Tsjakka/PowerMeter/Hardware/PowerMeter_v2_PCB_koper.png

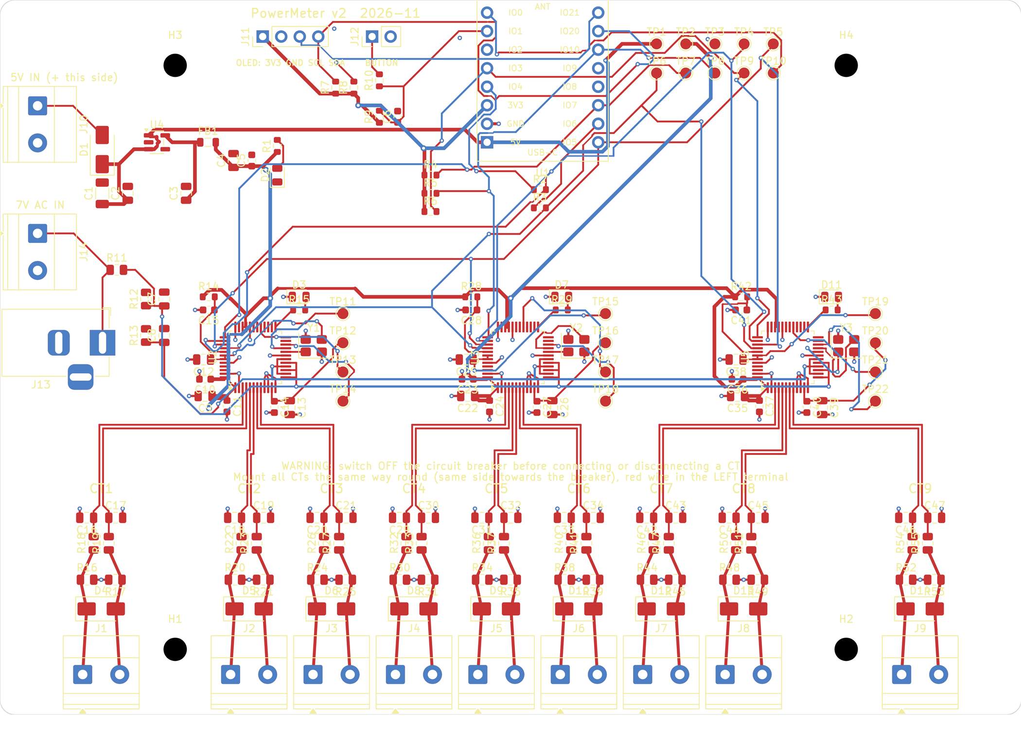
Hardware/PowerMeter_v2_PCB_koper.png
