Tsjakka/PowerMeter/Hardware/PowerMeter_v2_BOM.csv

Designator | Value | Footprint | LCSC | Qty | DNP
C1 | 22u 10V | Capacitor_SMD:C_1206_3216Metric | C12891 | 1
C2-C4,C9,C12,C22,C25,C35,C38 | 10u | Capacitor_SMD:C_0805_2012Metric | C15850 | 9
C5,C6,C10,C11,C14,C15,C23,C24,C27,C28,C36,C37,C40,C41 | 100n | Capacitor_SMD:C_0603_1608Metric | C14663 | 14
C7,C8,C16-C21,C29-C34,C42-C51 | 33n C0G | Capacitor_SMD:C_0805_2012Metric | C1518212 | 24
C13,C26,C39 | 4.7u | Capacitor_SMD:C_0805_2012Metric | C1779 | 3
D1 | SS14 | Diode_SMD:D_SMA | C2480 | 1
D2,D3,D7,D11 | groen | LED_SMD:LED_0805_2012Metric | C2297 | 4
D4-D6,D8-D10,D12-D14 | SMAJ5.0CA | Diode_SMD:D_SMA | C140894 | 9
FB1 | 600R@100MHz | Inductor_SMD:L_0805_2012Metric | C1017 | 1
J1 | CT1 | TerminalBlock_Phoenix:TerminalBlock_Phoenix_MKDS-1,5-2-5.08_1x02_P5.08mm_Horizontal |  | 1
J2 | CT2 | TerminalBlock_Phoenix:TerminalBlock_Phoenix_MKDS-1,5-2-5.08_1x02_P5.08mm_Horizontal |  | 1
J3 | CT3 | TerminalBlock_Phoenix:TerminalBlock_Phoenix_MKDS-1,5-2-5.08_1x02_P5.08mm_Horizontal |  | 1
J4 | CT4 | TerminalBlock_Phoenix:TerminalBlock_Phoenix_MKDS-1,5-2-5.08_1x02_P5.08mm_Horizontal |  | 1
J5 | CT5 | TerminalBlock_Phoenix:TerminalBlock_Phoenix_MKDS-1,5-2-5.08_1x02_P5.08mm_Horizontal |  | 1
J6 | CT6 | TerminalBlock_Phoenix:TerminalBlock_Phoenix_MKDS-1,5-2-5.08_1x02_P5.08mm_Horizontal |  | 1
J7 | CT7 | TerminalBlock_Phoenix:TerminalBlock_Phoenix_MKDS-1,5-2-5.08_1x02_P5.08mm_Horizontal |  | 1
J8 | CT8 | TerminalBlock_Phoenix:TerminalBlock_Phoenix_MKDS-1,5-2-5.08_1x02_P5.08mm_Horizontal |  | 1
J9 | CT9 | TerminalBlock_Phoenix:TerminalBlock_Phoenix_MKDS-1,5-2-5.08_1x02_P5.08mm_Horizontal |  | 1
J10 | 5V in | TerminalBlock_Phoenix:TerminalBlock_Phoenix_MKDS-1,5-2-5.08_1x02_P5.08mm_Horizontal |  | 1
J11 | OLED SSD1306 I2C | Connector_PinHeader_2.54mm:PinHeader_1x04_P2.54mm_Vertical |  | 1
J12 | Knop | Connector_PinHeader_2.54mm:PinHeader_1x02_P2.54mm_Vertical |  | 1
J13 | 7V AC L1 (jack) | Connector_BarrelJack:BarrelJack_Horizontal |  | 1
J14 | 7V AC L1 | TerminalBlock_Phoenix:TerminalBlock_Phoenix_MKDS-1,5-2-5.08_1x02_P5.08mm_Horizontal |  | 1
J15 | 7V AC L2 | TerminalBlock_Phoenix:TerminalBlock_Phoenix_MKDS-1,5-2-5.08_1x02_P5.08mm_Horizontal |  | 1
J16 | 7V AC L3 | TerminalBlock_Phoenix:TerminalBlock_Phoenix_MKDS-1,5-2-5.08_1x02_P5.08mm_Horizontal |  | 1
R1,R10,R15,R29,R43 | 1k | Resistor_SMD:R_0603_1608Metric | C21190 | 5
R2,R3 | 33 | Resistor_SMD:R_0603_1608Metric | C23140 | 2
R4-R6,R9,R14,R28,R42 | 10k | Resistor_SMD:R_0603_1608Metric | C25804 | 7
R7,R8 | 4.7k | Resistor_SMD:R_0603_1608Metric | C23162 | 2 | DNP
R11,R56,R59 | 22k 1% | Resistor_SMD:R_0805_2012Metric | C17560 | 3
R12,R13,R18,R19,R22,R23,R26,R27,R32,R33,R36,R37,R40,R41,R46,R47,R50,R51,R54,R55,R57,R58,R60,R61 | 1k 1% | Resistor_SMD:R_0805_2012Metric | C17513 | 24
R16,R17,R20,R21,R24,R25,R30,R31,R34,R35,R38,R39,R44,R45,R48,R49,R52,R53 | 22 1% | Resistor_SMD:R_0805_2012Metric | C17561 | 18
U1 | ESP32-C3 SuperMini | PowerMeter:ESP32-C3_SuperMini_Socket |  | 1
U2,U3,U5 | ATM90E32AS | Package_QFP:TQFP-48_7x7mm_P0.5mm | C177153 | 3
U4 | AP2112K-3.3 | Package_TO_SOT_SMD:SOT-23-5 | C51118 | 1
Y1-Y3 | 16.384MHz | Crystal:Crystal_SMD_3225-4Pin_3.2x2.5mm | C13739 | 3
