Tsjakka/PowerMeter/Hardware/PowerMeter_v2_schema.pdf

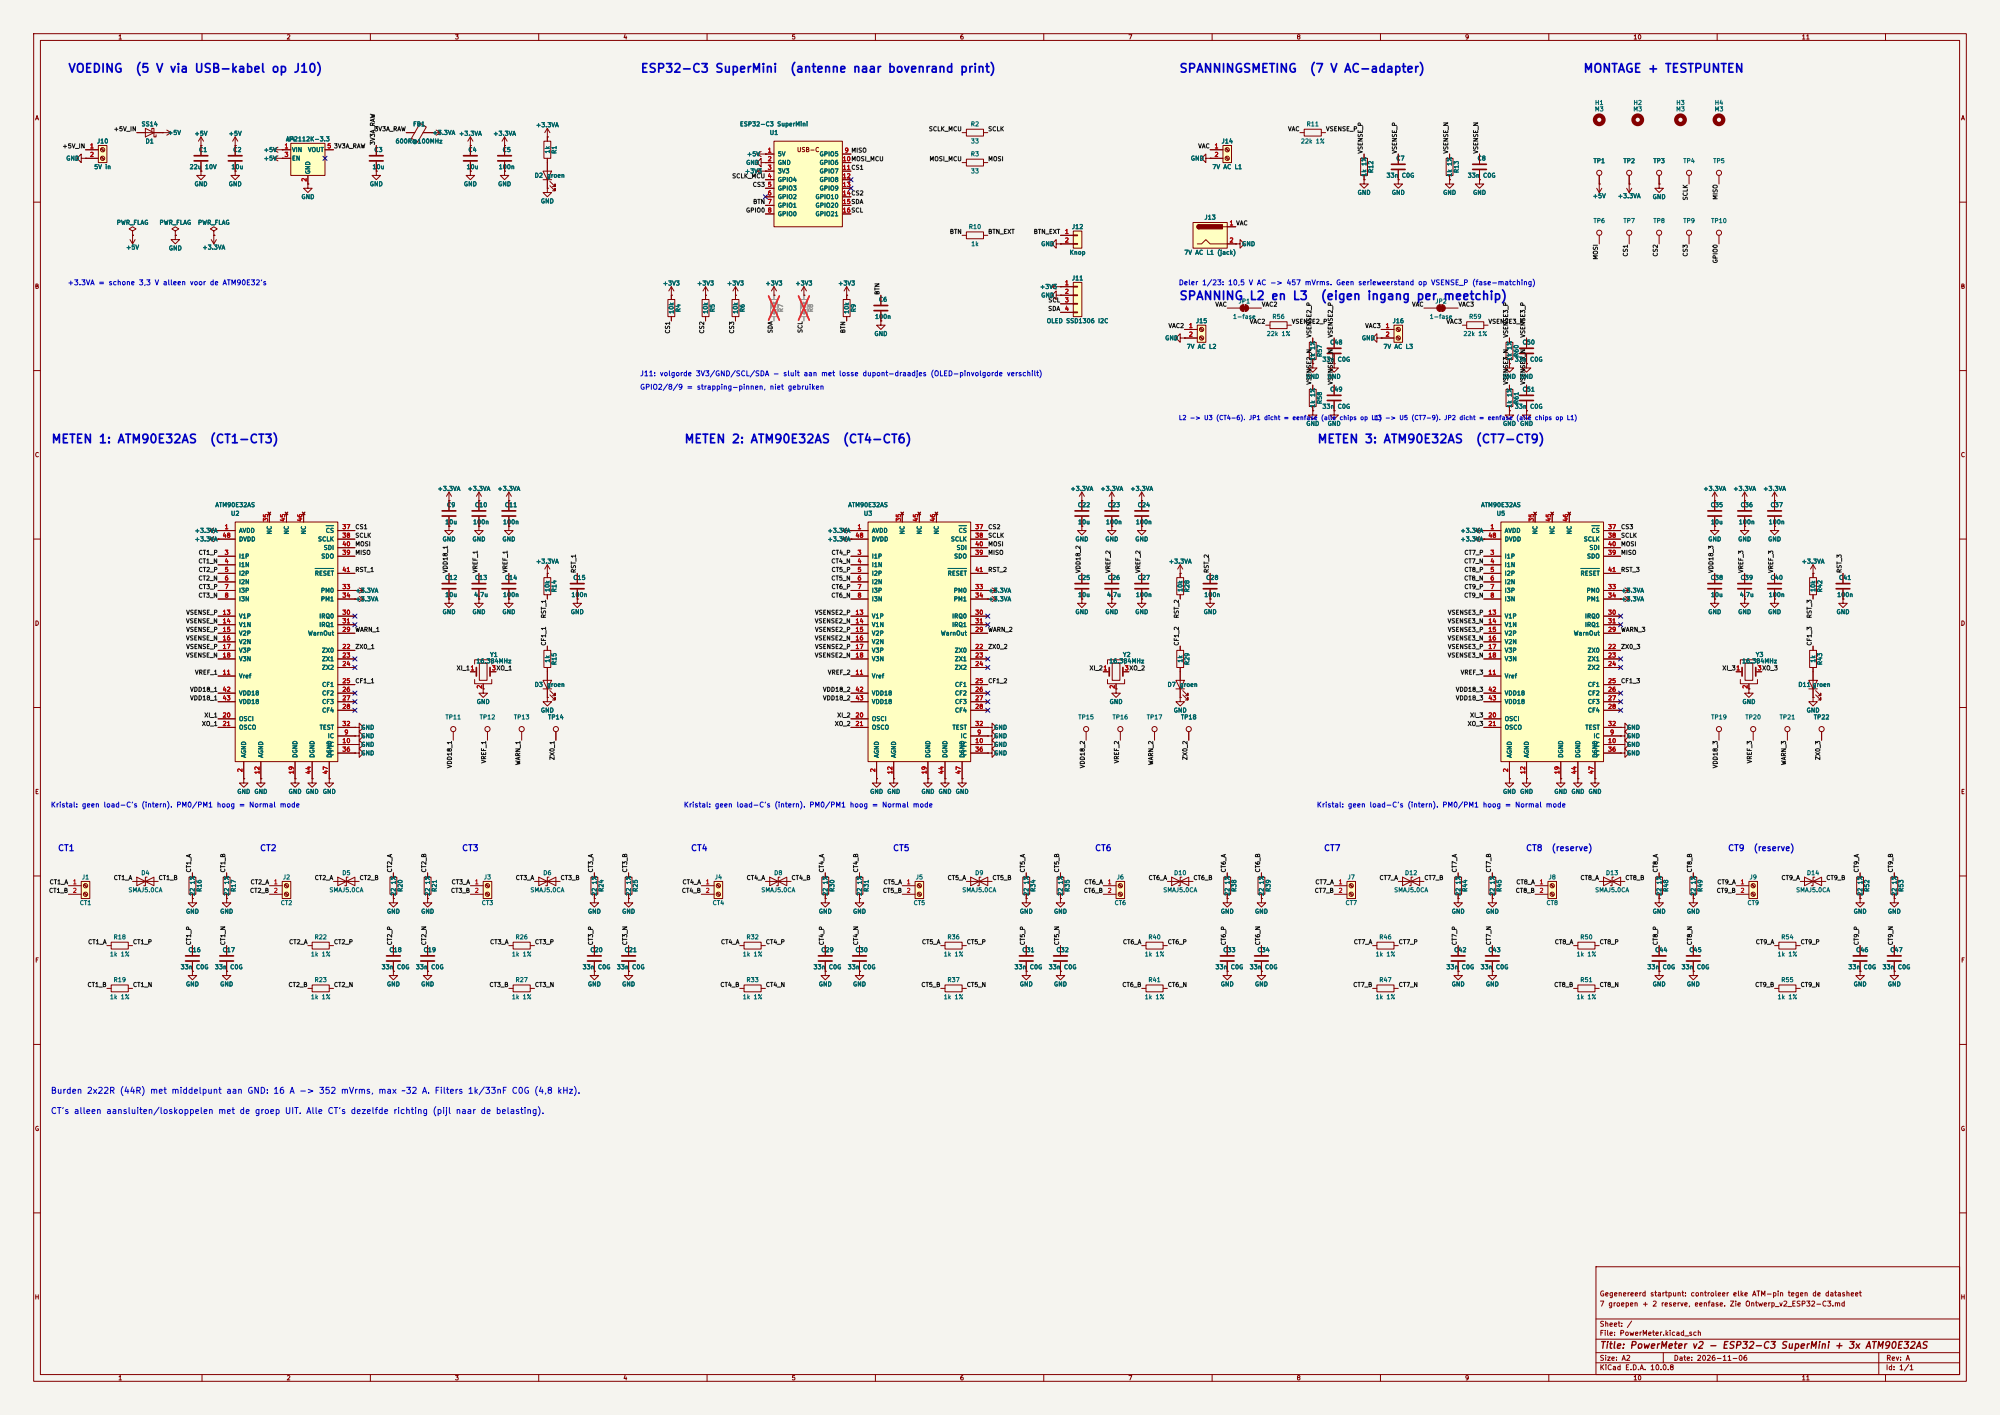
[picture p3: page 1]

VOEDING (5 V via USB-kabel op J10)

ESP32-C3 SuperMini (antenne naar bovenrand print)

+3.3VA = schone 3,3 V alleen voor de ATM90E32's

Deler 1/23: 10,5 V AC -> 457 mVrms. Geen serieweerstand op VSENSE_P (fase-matching)
SPANNING L2 en L3 (eigen ingang per meetchip)

J11: volgorde 3V3/GND/SCL/SDA - sluit aan met losse dupont-draadjes (OLED-pinvolgorde verschilt)
GPIO2/8/9 = strapping-pinnen, niet gebruiken

L2 -> U3 (CT4-6). JP1 dicht = eenfase (alle chips op L1)

L3 -> U5 (CT7-9). JP2 dicht = eenfase (alle chips op L1)

Kristal: geen load-C's (intern). PM0/PM1 hoog = Normal mode

Burden 2x22R (44R) met middelpunt aan GND: 16 A -> 352 mVrms, max ~32 A. Filters 1k/33nF C0G (4,8 kHz).

CT's alleen aansluiten/loskoppelen met de groep UIT. Alle CT's dezelfde richting (pijl naar de belasting).

Gegenereerd startpunt: controleer elke ATM-pin tegen de datasheet
7 groepen + 2 reserve, eenfase. Zie Ontwerp_v2_ESP32-C3.md

Size: A2 | Rev: A
KiCad E.D.A. 10.0.8 | Id: 1/1
