Tsjakka/PowerMeter/Hardware/PowerMeter.kicad_pcb

## KiCad design Hardware/PowerMeter.kicad_pcb (2026-11-10)

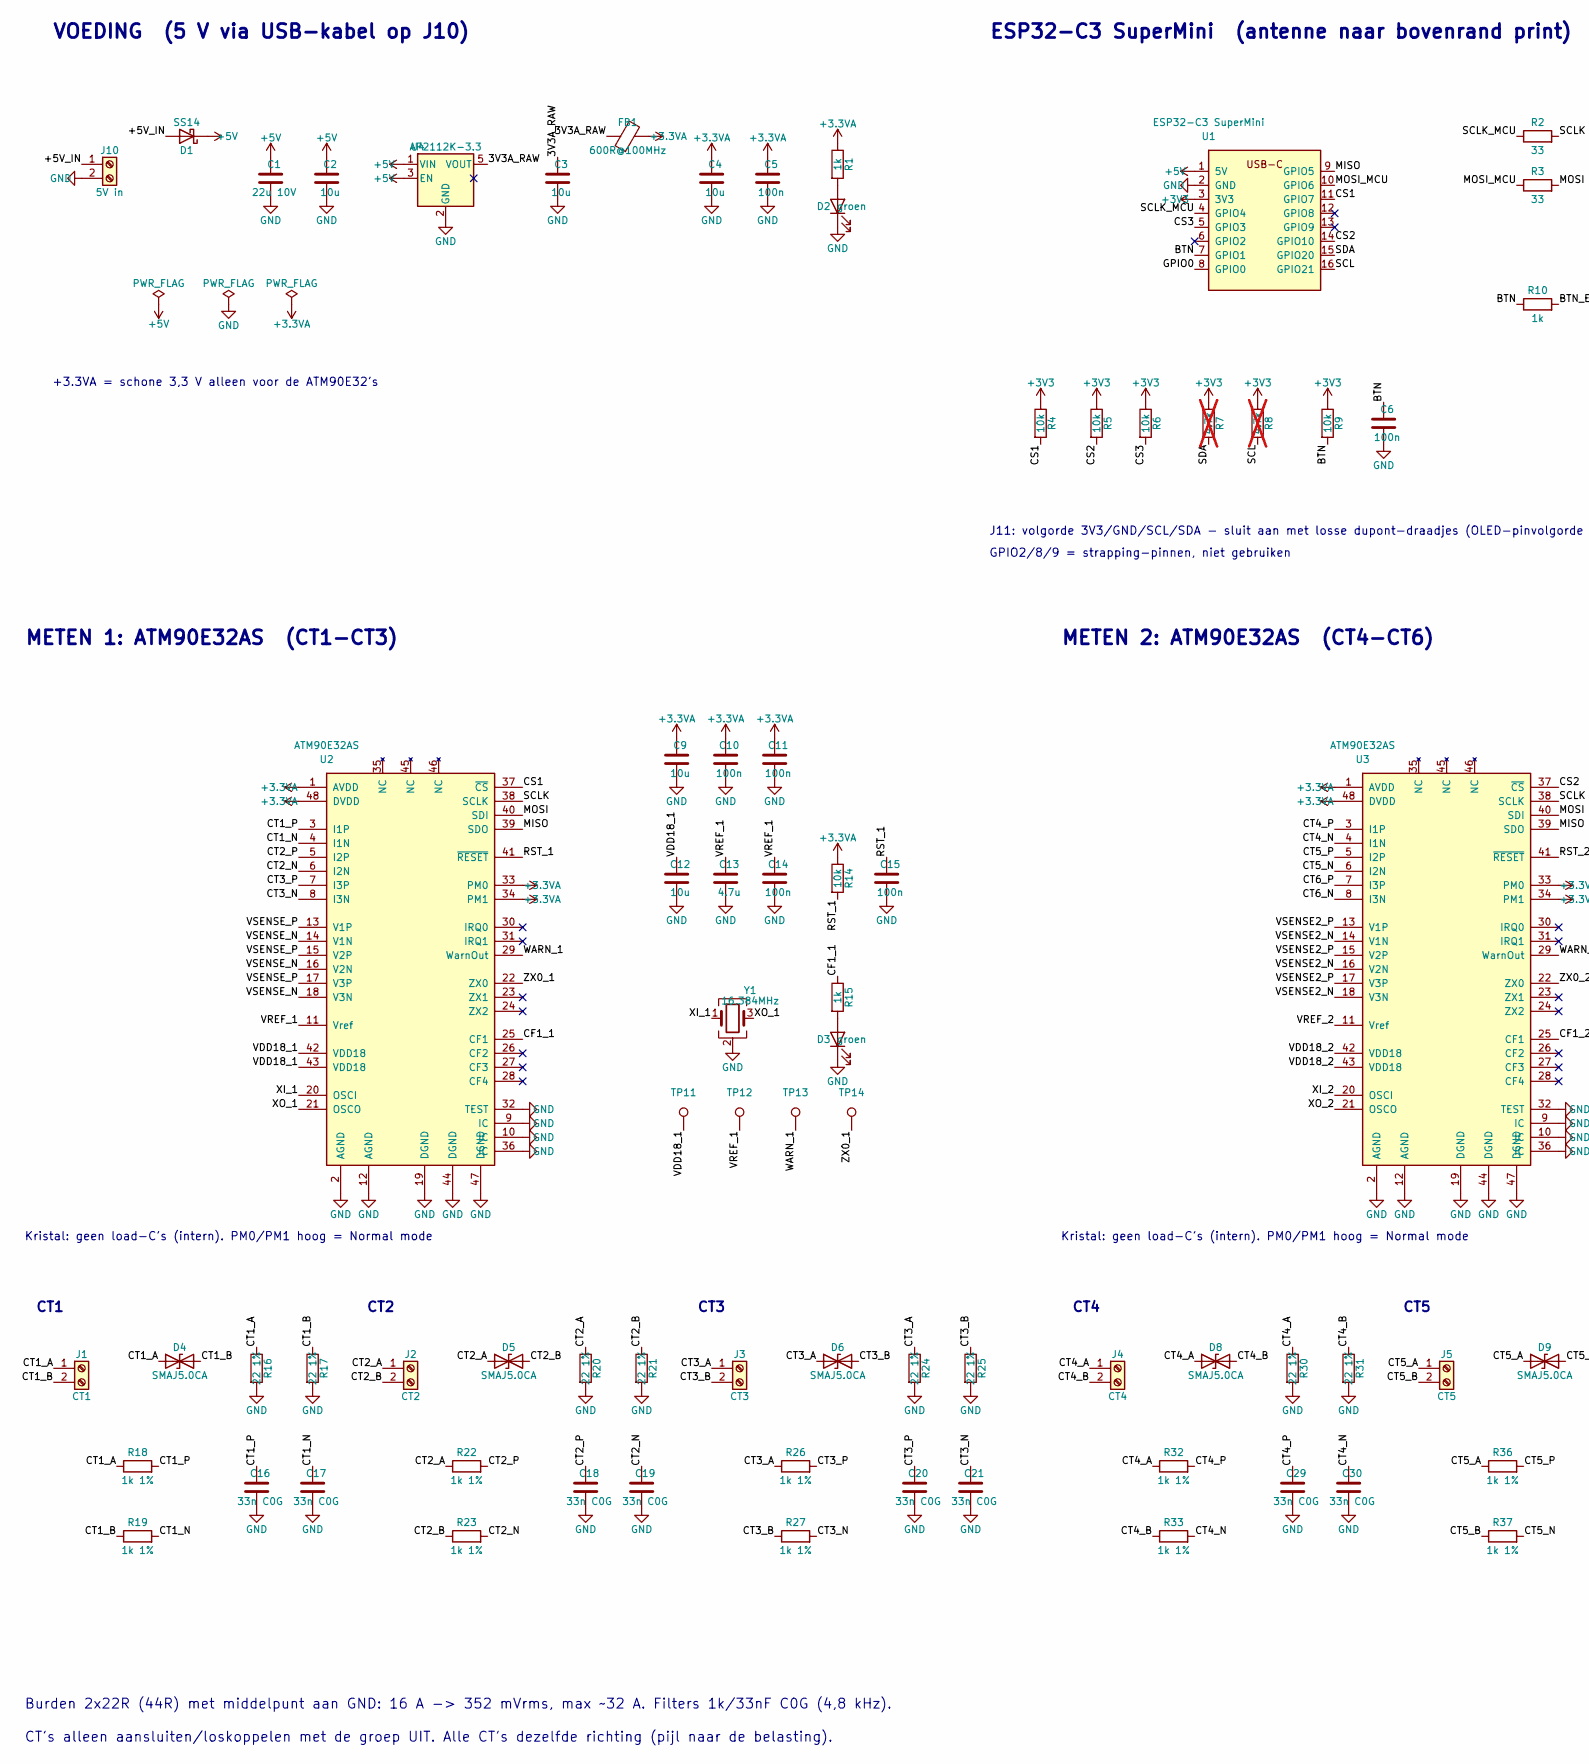
[picture p4: schematic PowerMeter.kicad_sch, PowerMeter v2 - ESP32-C3 SuperMini + 3x ATM90E32AS, part in row 1, column 1]

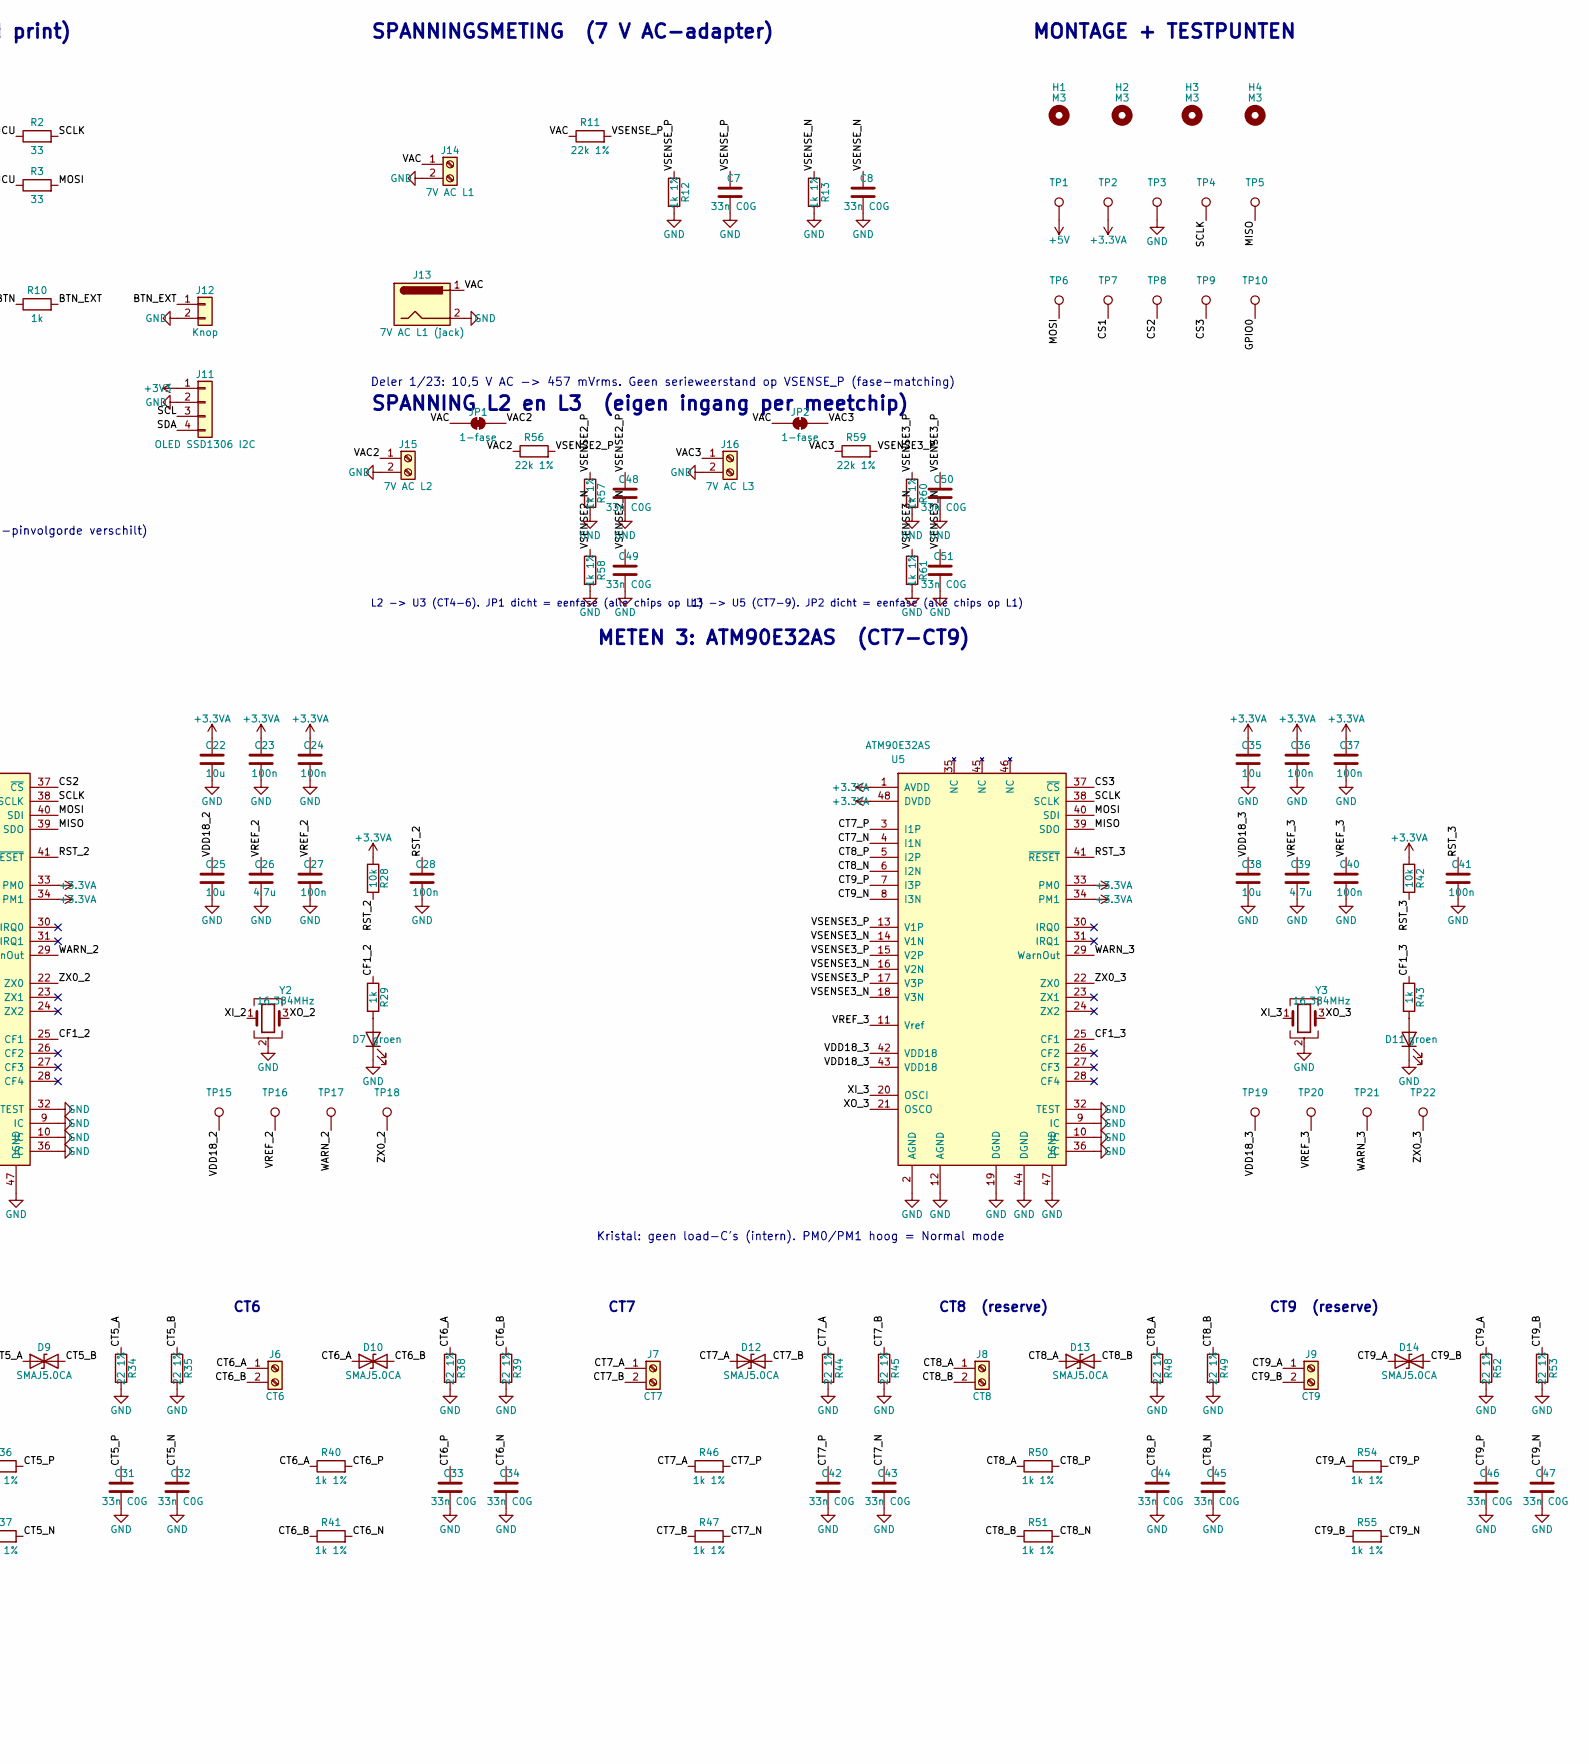
[picture p5: schematic PowerMeter.kicad_sch, PowerMeter v2 - ESP32-C3 SuperMini + 3x ATM90E32AS, part in row 1, column 2]

Parts:
C1: 22u 10V; C_1206_3216Metric; LCSC C12891
C2, C3, C4, C9, C12, C22, C25, C35, C38: 10u; C_0805_2012Metric; LCSC C15850
C5, C6, C10, C11, C14, C15, C23, C24, C27, C28, C36, C37, C40, C41: 100n; C_0603_1608Metric; LCSC C14663
C7, C8, C16, C17, C18, C19, C20, C21, C29, C30, C31, C32, C33, C34, C42, C43, C44, C45, C46, C47, C48, C49, C50, C51: 33n C0G; C_0805_2012Metric; LCSC C1518212
C13, C26, C39: 4.7u; C_0805_2012Metric; LCSC C1779
D1: SS14; D_SMA; LCSC C2480
D2, D3, D7, D11: groen; LED_0805_2012Metric; LCSC C2297
D4, D5, D6, D8, D9, D10, D12, D13, D14: SMAJ5.0CA; D_SMA; LCSC C140894
FB1: 600R@100MHz; L_0805_2012Metric; LCSC C1017
H1, H2, H3, H4: M3; MountingHole_3.2mm_M3
J1: CT1; TerminalBlock_Phoenix_MKDS-1,5-2-5.08_1x02_P5.08mm_Horizont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
J2: CT2; TerminalBlock_Phoenix_MKDS-1,5-2-5.08_1x02_P5.08mm_Horizont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
J3: CT3; TerminalBlock_Phoenix_MKDS-1,5-2-5.08_1x02_P5.08mm_Horizont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
J4: CT4; TerminalBlock_Phoenix_MKDS-1,5-2-5.08_1x02_P5.08mm_Horizont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
J5: CT5; TerminalBlock_Phoenix_MKDS-1,5-2-5.08_1x02_P5.08mm_Horizont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
J6: CT6; TerminalBlock_Phoenix_MKDS-1,5-2-5.08_1x02_P5.08mm_Horizont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
J7: CT7; TerminalBlock_Phoenix_MKDS-1,5-2-5.08_1x02_P5.08mm_Horizont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
J8: CT8; TerminalBlock_Phoenix_MKDS-1,5-2-5.08_1x02_P5.08mm_Horizont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
J9: CT9; TerminalBlock_Phoenix_MKDS-1,5-2-5.08_1x02_P5.08mm_Horizont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
J10: 5V in; TerminalBlock_Phoenix_MKDS-1,5-2-5.08_1x02_P5.08mm_Horizont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
J11: OLED SSD1306 I2C; PinHeader_1x04_P2.54mm_Vertical
J12: Knop; PinHeader_1x02_P2.54mm_Vertical
J13: 7V AC L1 (jack); BarrelJack_Horizontal
J14: 7V AC L1; TerminalBlock_Phoenix_MKDS-1,5-2-5.08_1x02_P5.08mm_Horizont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
J15: 7V AC L2; TerminalBlock_Phoenix_MKDS-1,5-2-5.08_1x02_P5.08mm_Horizont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
J16: 7V AC L3; TerminalBlock_Phoenix_MKDS-1,5-2-5.08_1x02_P5.08mm_Horizont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
JP1, JP2: 1-fase; SolderJumper-2_P1.3mm_Bridged_RoundedPad1.0x1.5mm
R1, R10, R15, R29, R43: 1k; R_0603_1608Metric; LCSC C21190
R2, R3: 33; R_0603_1608Metric; LCSC C23140
R4, R5, R6, R9, R14, R28, R42: 10k; R_0603_1608Metric; LCSC C25804
R7, R8: 4.7k; R_0603_1608Metric; LCSC C23162; not fitted
R11, R56, R59: 22k 1%; R_0805_2012Metric; LCSC C17560
R12, R13, R18, R19, R22, R23, R26, R27, R32, R33, R36, R37, R40, R41, R46, R47, R50, R51, R54, R55, R57, R58, R60, R61: 1k 1%; R_0805_2012Metric; LCSC C17513
R16, R17, R20, R21, R24, R25, R30, R31, R34, R35, R38, R39, R44, R45, R48, R49, R52, R53: 22 1%; R_0805_2012Metric; LCSC C17561
TP1: +5V; TestPoint_Pad_D1.5mm
TP2: +3.3VA; TestPoint_Pad_D1.5mm
TP3: GND; TestPoint_Pad_D1.5mm
TP4: SCLK; TestPoint_Pad_D1.5mm
TP5: MISO; TestPoint_Pad_D1.5mm
TP6: MOSI; TestPoint_Pad_D1.5mm
TP7: CS1; TestPoint_Pad_D1.5mm
TP8: CS2; TestPoint_Pad_D1.5mm
TP9: CS3; TestPoint_Pad_D1.5mm
TP10: GPIO0; TestPoint_Pad_D1.5mm
TP11: VDD18_1; TestPoint_Pad_D1.5mm
TP12: VREF_1; TestPoint_Pad_D1.5mm
TP13: WARN_1; TestPoint_Pad_D1.5mm
TP14: ZX0_1; TestPoint_Pad_D1.5mm
TP15: VDD18_2; TestPoint_Pad_D1.5mm
TP16: VREF_2; TestPoint_Pad_D1.5mm
TP17: WARN_2; TestPoint_Pad_D1.5mm
TP18: ZX0_2; TestPoint_Pad_D1.5mm
TP19: VDD18_3; TestPoint_Pad_D1.5mm
TP20: VREF_3; TestPoint_Pad_D1.5mm
TP21: WARN_3; TestPoint_Pad_D1.5mm
TP22: ZX0_3; TestPoint_Pad_D1.5mm
U1: ESP32-C3 SuperMini; ESP32-C3_SuperMini_Socket
U2, U3, U5: ATM90E32AS; TQFP-48_7x7mm_P0.5mm; LCSC C177153
U4: AP2112K-3.3; SOT-23-5; LCSC C51118
Y1, Y2, Y3: 16.384MHz; Crystal_SMD_3225-4Pin_3.2x2.5mm; LCSC C13739

Connections:
+3.3VA: C4.1, C5.1, C9.1, C10.1, C11.1, C22.1, C23.1, C24.1, C35.1, C36.1, C37.1, FB1.2, R1.1, R14.1, R28.1, R42.1, TP2.1, U2.1 (AVDD), U2.33 (PM0), U2.34 (PM1), U2.48 (DVDD), U3.1 (AVDD), U3.33 (PM0), U3.34 (PM1), U3.48 (DVDD), U5.1 (AVDD), U5.33 (PM0), U5.34 (PM1), U5.48 (DVDD)
+3V3: J11.1, R4.1, R5.1, R6.1, R7.1, R8.1, R9.1, U1.3 (3V3)
+5V: C1.1, C2.1, D1.1 (K), TP1.1, U1.1 (5V), U4.1 (VIN), U4.3 (EN)
/3V3A_RAW: C3.1, FB1.1, U4.5 (VOUT)
/+5V_IN: D1.2 (A), J10.1
/BTN: C6.1, R9.2, R10.1, U1.7 (GPIO1)
/BTN_EXT: J12.1, R10.2
/CF1_1: R15.1, U2.25 (CF1)
/CF1_2: R29.1, U3.25 (CF1)
/CF1_3: R43.1, U5.25 (CF1)
/CS1: R4.2, TP7.1, U1.11 (GPIO7), U2.37 (~CS)
/CS2: R5.2, TP8.1, U1.14 (GPIO10), U3.37 (~CS)
/CS3: R6.2, TP9.1, U1.5 (GPIO3), U5.37 (~CS)
/CT1_A: D4.1 (A1), J1.1, R16.1, R18.1
/CT1_B: D4.2 (A2), J1.2, R17.1, R19.1
/CT1_N: C17.1, R19.2, U2.4 (I1N)
/CT1_P: C16.1, R18.2, U2.3 (I1P)
/CT2_A: D5.1 (A1), J2.1, R20.1, R22.1
/CT2_B: D5.2 (A2), J2.2, R21.1, R23.1
/CT2_N: C19.1, R23.2, U2.6 (I2N)
/CT2_P: C18.1, R22.2, U2.5 (I2P)
/CT3_A: D6.1 (A1), J3.1, R24.1, R26.1
/CT3_B: D6.2 (A2), J3.2, R25.1, R27.1
/CT3_N: C21.1, R27.2, U2.8 (I3N)
/CT3_P: C20.1, R26.2, U2.7 (I3P)
/CT4_A: D8.1 (A1), J4.1, R30.1, R32.1
/CT4_B: D8.2 (A2), J4.2, R31.1, R33.1
/CT4_N: C30.1, R33.2, U3.4 (I1N)
/CT4_P: C29.1, R32.2, U3.3 (I1P)
/CT5_A: D9.1 (A1), J5.1, R34.1, R36.1
/CT5_B: D9.2 (A2), J5.2, R35.1, R37.1
/CT5_N: C32.1, R37.2, U3.6 (I2N)
/CT5_P: C31.1, R36.2, U3.5 (I2P)
/CT6_A: D10.1 (A1), J6.1, R38.1, R40.1
/CT6_B: D10.2 (A2), J6.2, R39.1, R41.1
/CT6_N: C34.1, R41.2, U3.8 (I3N)
/CT6_P: C33.1, R40.2, U3.7 (I3P)
/CT7_A: D12.1 (A1), J7.1, R44.1, R46.1
/CT7_B: D12.2 (A2), J7.2, R45.1, R47.1
/CT7_N: C43.1, R47.2, U5.4 (I1N)
/CT7_P: C42.1, R46.2, U5.3 (I1P)
/CT8_A: D13.1 (A1), J8.1, R48.1, R50.1
/CT8_B: D13.2 (A2), J8.2, R49.1, R51.1
/CT8_N: C45.1, R51.2, U5.6 (I2N)
/CT8_P: C44.1, R50.2, U5.5 (I2P)
/CT9_A: D14.1 (A1), J9.1, R52.1, R54.1
/CT9_B: D14.2 (A2), J9.2, R53.1, R55.1
/CT9_N: C47.1, R55.2, U5.8 (I3N)
/CT9_P: C46.1, R54.2, U5.7 (I3P)
/GPIO0: TP10.1, U1.8 (GPIO0)
/MISO: TP5.1, U1.9 (GPIO5), U2.39 (SDO), U3.39 (SDO), U5.39 (SDO)
/MOSI: R3.2, TP6.1, U2.40 (SDI), U3.40 (SDI), U5.40 (SDI)
/MOSI_MCU: R3.1, U1.10 (GPIO6)
/RST_1: C15.1, R14.2, U2.41 (~RESET)
/RST_2: C28.1, R28.2, U3.41 (~RESET)
/RST_3: C41.1, R42.2, U5.41 (~RESET)
/SCL: J11.3, R8.2, U1.16 (GPIO21)
/SCLK: R2.2, TP4.1, U2.38 (SCLK), U3.38 (SCLK), U5.38 (SCLK)
/SCLK_MCU: R2.1, U1.4 (GPIO4)
/SDA: J11.4, R7.2, U1.15 (GPIO20)
/VAC: J13.1, J14.1, JP1.1 (A), JP2.1 (A), R11.1
/VAC2: J15.1, JP1.2 (B), R56.1
/VAC3: J16.1, JP2.2 (B), R59.1
/VDD18_1: C12.1, TP11.1, U2.42 (VDD18), U2.43 (VDD18)
/VDD18_2: C25.1, TP15.1, U3.42 (VDD18), U3.43 (VDD18)
/VDD18_3: C38.1, TP19.1, U5.42 (VDD18), U5.43 (VDD18)
/VREF_1: C13.1, C14.1, TP12.1, U2.11 (Vref)
/VREF_2: C26.1, C27.1, TP16.1, U3.11 (Vref)
/VREF_3: C39.1, C40.1, TP20.1, U5.11 (Vref)
/VSENSE2_N: C49.1, R58.1, U3.14 (V1N), U3.16 (V2N), U3.18 (V3N)
/VSENSE2_P: C48.1, R56.2, R57.1, U3.13 (V1P), U3.15 (V2P), U3.17 (V3P)
/VSENSE3_N: C51.1, R61.1, U5.14 (V1N), U5.16 (V2N), U5.18 (V3N)
/VSENSE3_P: C50.1, R59.2, R60.1, U5.13 (V1P), U5.15 (V2P), U5.17 (V3P)
/VSENSE_N: C8.1, R13.1, U2.14 (V1N), U2.16 (V2N), U2.18 (V3N)
/VSENSE_P: C7.1, R11.2, R12.1, U2.13 (V1P), U2.15 (V2P), U2.17 (V3P)
/WARN_1: TP13.1, U2.29 (WarnOut)
/WARN_2: TP17.1, U3.29 (WarnOut)
/WARN_3: TP21.1, U5.29 (WarnOut)
/XI_1: U2.20 (OSCI), Y1.1
/XI_2: U3.20 (OSCI), Y2.1
/XI_3: U5.20 (OSCI), Y3.1
/XO_1: U2.21 (OSCO), Y1.3
/XO_2: U3.21 (OSCO), Y2.3
/XO_3: U5.21 (OSCO), Y3.3
/ZX0_1: TP14.1, U2.22 (ZX0)
/ZX0_2: TP18.1, U3.22 (ZX0)
/ZX0_3: TP22.1, U5.22 (ZX0)
GND: C1.2, C2.2, C3.2, C4.2, C5.2, C6.2, C7.2, C8.2, C9.2, C10.2, C11.2, C12.2, C13.2, C14.2, C15.2, C16.2, C17.2, C18.2, C19.2, C20.2, C21.2, C22.2, C23.2, C24.2, C25.2, C26.2, C27.2, C28.2, C29.2, C30.2, C31.2, C32.2, C33.2, C34.2, C35.2, C36.2, C37.2, C38.2, C39.2, C40.2, C41.2, C42.2, C43.2, C44.2, C45.2, C46.2, C47.2, C48.2, C49.2, C50.2, C51.2, D2.1 (K), D3.1 (K), D7.1 (K), D11.1 (K), J10.2, J11.2, J12.2, J13.2, J14.2, J15.2, J16.2, R12.2, R13.2, R16.2, R17.2, R20.2, R21.2, R24.2, R25.2, R30.2, R31.2, R34.2, R35.2, R38.2, R39.2, R44.2, R45.2, R48.2, R49.2, R52.2, R53.2, R57.2, R58.2, R60.2, R61.2, TP3.1, U1.2 (GND), U2.2 (AGND), U2.9 (IC), U2.10 (IC), U2.12 (AGND), U2.19 (DGND), U2.32 (TEST), U2.36 (IC), U2.44 (DGND), U2.47 (DGND), U3.2 (AGND), U3.9 (IC), U3.10 (IC), U3.12 (AGND), U3.19 (DGND), U3.32 (TEST), U3.36 (IC), U3.44 (DGND), U3.47 (DGND), U4.2 (GND), U5.2 (AGND), U5.9 (IC), U5.10 (IC), U5.12 (AGND), U5.19 (DGND), U5.32 (TEST), U5.36 (IC), U5.44 (DGND), U5.47 (DGND), Y1.2 (G), Y1.4 (G), Y2.2 (G), Y2.4 (G), Y3.2 (G), Y3.4 (G)
unnamed: D2.2 (A), R1.2
unnamed: D3.2 (A), R15.2
unnamed: D7.2 (A), R29.2
unnamed: D11.2 (A), R43.2

Notes on the sheet:
VOEDING (5 V via USB-kabel op J10)
+3.3VA = schone 3,3 V alleen voor de ATM90E32's
ESP32-C3 SuperMini (antenne naar bovenrand print)
J11: volgorde 3V3/GND/SCL/SDA - sluit aan met losse dupont-draadjes (OLED-pinvolgorde verschilt)
GPIO2/8/9 = strapping-pinnen, niet gebruiken
SPANNINGSMETING (7 V AC-adapter)
Deler 1/23: 10,5 V AC -> 457 mVrms. Geen serieweerstand op VSENSE_P (fase-matching)
MONTAGE + TESTPUNTEN
METEN 1: ATM90E32AS (CT1-CT3)
Kristal: geen load-C's (intern). PM0/PM1 hoog = Normal mode
CT1
CT2
CT3
METEN 2: ATM90E32AS (CT4-CT6)
CT4
CT5
CT6
METEN 3: ATM90E32AS (CT7-CT9)
CT7
CT8 (reserve)
CT9 (reserve)
Burden 2x22R (44R) met middelpunt aan GND: 16 A -> 352 mVrms, max ~32 A. Filters 1k/33nF C0G (4,8 kHz).
CT's alleen aansluiten/loskoppelen met de groep UIT. Alle CT's dezelfde richting (pijl naar de belasting).
SPANNING L2 en L3 (eigen ingang per meetchip)
L2 -> U3 (CT4-6). JP1 dicht = eenfase (alle chips op L1)
L3 -> U5 (CT7-9). JP2 dicht = eenfase (alle chips op L1)

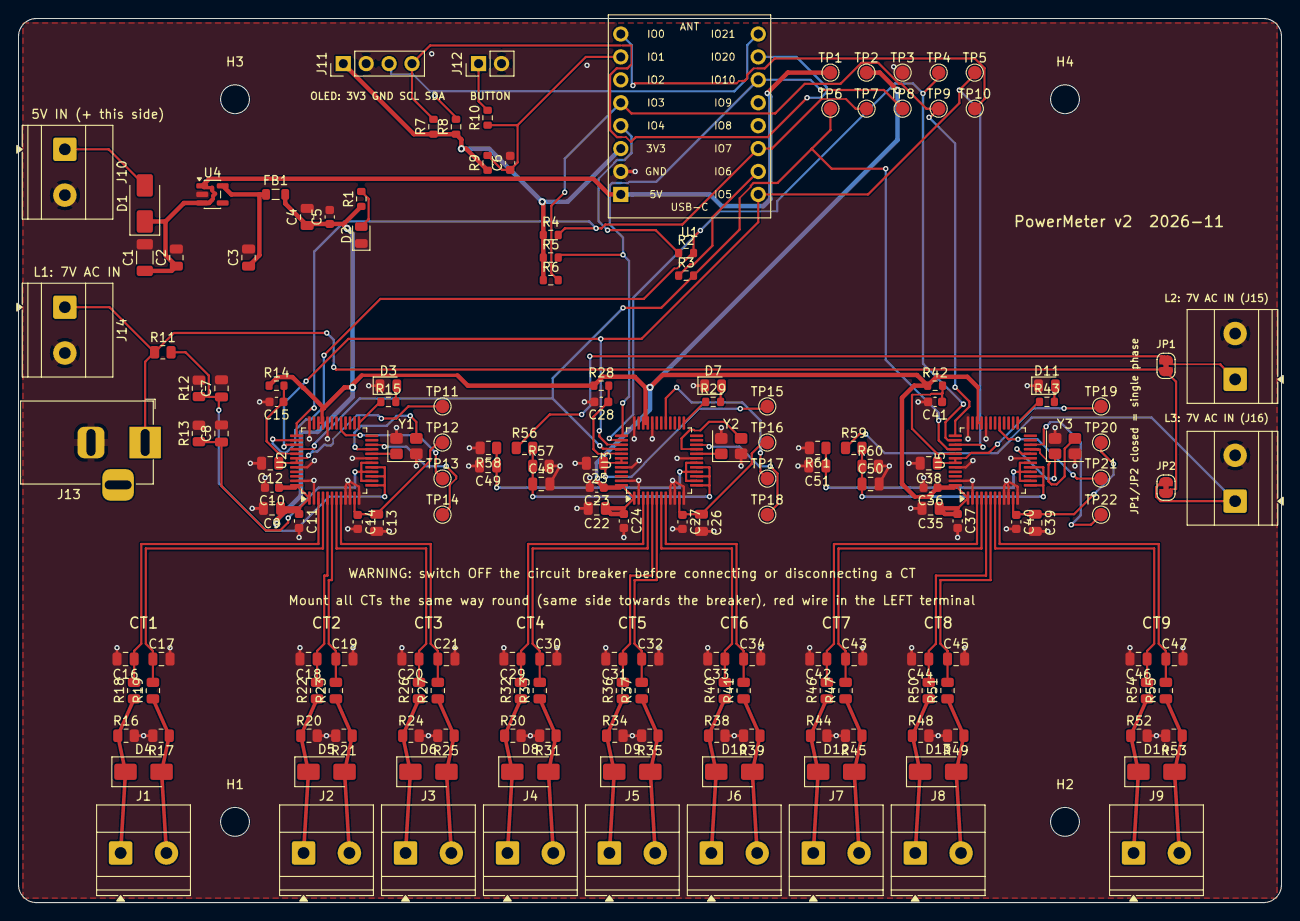
[picture p6: board PowerMeter.kicad_pcb from above]

Board: 2 copper layers, 140.0 x 98.0 mm, 179 parts (0 on the bottom side), 92 nets.
