Tsjakka/PowerMeter/(commit log)

2026-11-07 Initial commit containing the board design made by Claude on my directions.
    [JLCPCB_BOM.csv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]
2026-11-07 Add project README
    Describes the PowerMeter v2 hardware: features, measuring chain,
    key specs, ESP32-C3 pin assignment, repository layout, build and
    bring-up steps, safety notes and project background.
2026-11-10 Moved some texts around.
    [PowerMeter.kicad_pcb]
2026-11-10 Add a separate voltage input per metering chip (3-phase ready)
    Each ATM90E32AS now has its own 7 V AC input and 22k/1k divider:
    L1 = J14/J13 -> U2 (CT1-3), L2 = J15 -> U3 (CT4-6), L3 = J16 -> U5
    (CT7-9). Solder jumpers JP1/JP2 are closed in copper so a single
    adapter still feeds all three chips; cut them for three-phase use.
    - Schematic: VSENSE2/VSENSE3 nets, J15/J16, JP1/JP2, two dividers
    - PCB: shared VSENSE trunks replaced by locked per-chip feeds,
    new parts placed, VAC nets routed (ERC 0, DRC 0 errors/unconnected,
    0 parity issues)
    - Regenerated JLCPCB order files, schematic PDF, BOM and render
    - Updated design document, order notes and README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
    [JLCPCB_BOM.csv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]
